brkysnturk/turret_fcs/docs/cad/Flywheel_experiment_1.stl

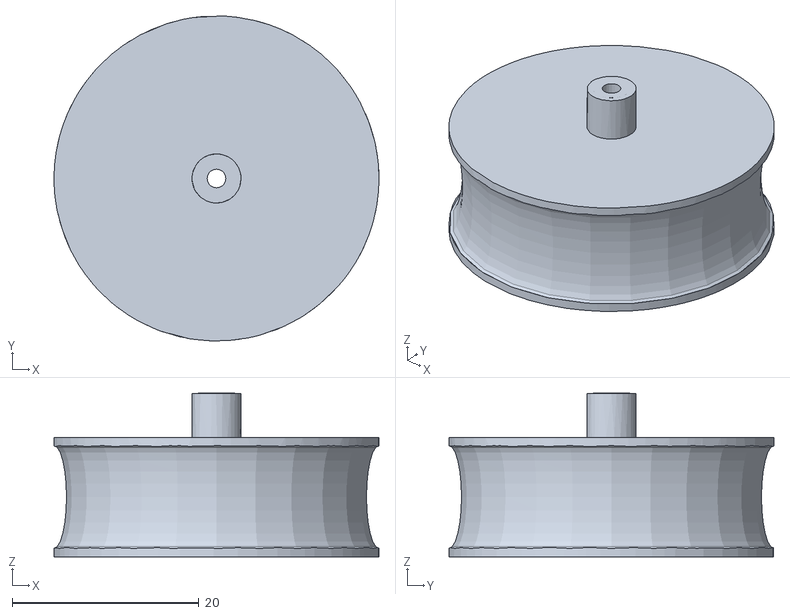
[picture p17: CAD file, 2026-10-21]
docs/cad/Flywheel_experiment_1.stl
34.8 x 34.8 x 17.5
