brkysnturk/turret_fcs/webots/worlds/tf_luna/TF-Luna 3D structure.obj

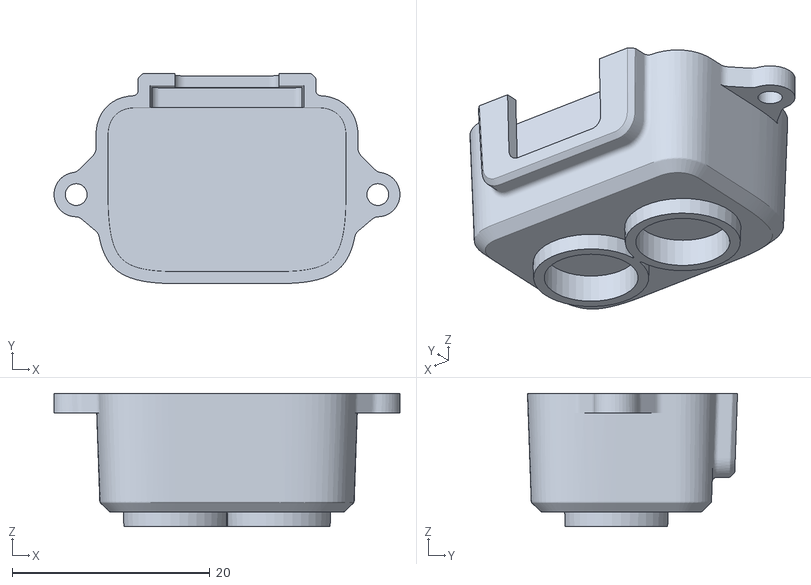
[picture p19: CAD file, 2026-10-05]
webots/worlds/tf_luna/TF-Luna 3D structure.obj
35.0 x 21.2 x 13.5
