brkysnturk/turret_fcs/(commit log)

2026-10-05 feat: initial commit - Turret FCS autonomous targeting, Webots simulation, and STM32 firmware
    [TF-Luna 3D structure.obj, red ballon.obj]
2026-10-05 feat(hsv): modernize and modularize C++ HSV pipeline with CLAHE, fast morphology, MJPG camera thread and analysis charts
2026-10-08 fix(control): align default controller gains and calibrate smooth Lissajous patrol baseline
    [fcs_manager.py, main.py, pid_controller.py]
2026-10-08 docs: update README with root analysis, telemetry logging and ESC shutdown
2026-10-08 feat(stm32): add STM32 Nucleo firmware project and clean standalone test folders
2026-10-11 feat(hardware): add 3D CAD mechanical assembly renders and update documentation
2026-10-13 feat(fcs): integrate P/RL hybrid controller, ego-motion Kalman filter, C270 optics, and 300 DPI analysis figures
2026-10-13 feat(release): v1.0.0 - 3-stage circular patrol, MIL-STD tactical HUD event log, and unified sensor fusion architecture
    - Core FCS: Integrated 3-stage calm circular/elliptical patrol generator (1.5s lost-target hold -> 20 deg/s smooth center return -> dual-axis sinusoidal conic scan)
    - Tactical HUD: Added MIL-STD tactical console event log with SSOT architecture, combat decluttering, strict color discipline (Green/Amber/Red), and graded hit probability
    - Embedded & Comms: Full-Duplex binary 115200 Baud UART (7B TX / 6B RX with XOR checksum), automatic ST-Link VID 0483 plug-and-play detection, and hardware-level TF-Luna LiDAR firmware interrupt (luna_read.c)
    - Simulation & Testing: Fully sync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
2026-10-14 feat(v1.1): 2-DOF velocity feedforward, pipeline-aligned PPO RL, and multi-tier fail-safe architecture
    [fcs_comm.py, fcs_manager.py, kalman_filter.py, main.c, main.py, rl_controller.py, target_selector.py]
2026-10-14 feat(v1.1): add 1st-order actuator observer for ego-motion compensation and sync UART docstring
2026-10-19 fix(fcs): make lock exit threshold dynamic with 0.60 deg hysteresis margin
    [lock_manager.py]
2026-10-19 refactor(config): standardize calibration comments to Ev: x | Okul: y format and remove legacy fallbacks
2026-10-20 feat(patrol): overhaul airspace patrol with odometry return-to-center, wide 45x16 angles, and unified tactical HUD
2026-10-20 feat(calibration): add interactive camera calibration tool and align optics to official 55 deg dFOV standard
2026-10-20 feat(control): add step accumulator for patrol RTB and dynamic velocity deadband
    - Add step accumulator in patrol_generator to overcome MG996R deadband during RTB
    - Implement dynamic Kalman velocity deadband scaling with ego-speed and distance
    - Introduce tracking hysteresis (conf=0.16) in target_selector to handle motion blur
    - Add real-time target_conf to telemetry CSV and HUD target label
    - Synchronize Webots HUD and update AGENTS.md and README.md
2026-10-21 feat(architecture): establish SSOT configuration, package structure, and repository hygiene
    [Flywheel_experiment_1.stl]
2026-10-21 feat(telemetry): implement telemetry v2 with hardware odometry sync and JSON metadata sidecar
2026-10-21 feat(control): calibrate adaptive CWNA Kalman filter, Type-1 P controller, and physical/eval lock management
2026-10-21 feat(rl): redesign LQR reward, optimize hyperparameters with Optuna, and retrain 250k PPO agent
    [rl_controller.py]
2026-10-21 fix(stm32): decouple telemetry from LiDAR, make watchdog unconditional, add atomic command read and step limits
    [fcs_comm.c, luna_read.c, main.c, servo_driver.c]
2026-10-21 test(ci): implement comprehensive 19-case pytest suite and robust GitHub Actions CI workflow
2026-10-21 feat(analysis): academic control analysis tools, publication figures, and benchmark evidence
    [v1.2_baseline.csv, v1.3_benchmark.csv]
2026-10-24 feat(kalman): replace the adaptive filter with a CV model
    [kalman_filter.py]
2026-10-24 feat(fcs): harden LiDAR gating, UART parsing, and the Webots twin
2026-10-24 refactor(control): make P and RL the single production controllers
    Promote the former P MAX to turret_fcs/p_controller.py (PController) and the former RL MAX to turret_fcs/rl_controller.py (RLController). Delete the legacy controllers, both factory selectors, the p_controller_impl / rl_controller_impl config fields, the TURRET_P_CONTROLLER / TURRET_RL_CONTROLLER switches, the kp_pan_max / kp_tilt_max aliases, and the v1.3 turret_ppo_final model. Rollback to v1.3 now means checking out the v1.3 tag.
    Remove never-read control config (velocity_ff_*, ff_min_speed_*, ff_full_speed_deg_s, ff_slew_rate_deg_s, ff_error_ramp_deg, ff_stop_*, p_pan_ema_alpha, p_pan_slew_deg, rl_pan_ema_alpha, rl_pan_s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
2026-10-24 fix(setup): make setup_env.bat run on a clean Windows clone
    The batch file failed with '... was unexpected at this time' because the venv/python checks were embedded in chained && blocks and nested if/else inside a parenthesis group. Rewrite it with explicit labels, quoted interpreter paths, and a :try_py helper so py -3.12/3.11/3.10 detection, venv rebuild, CPU-only torch install, editable package install, and import verification all run to completion.
    Verified on a fresh clone: first run from scratch and a second run with an existing venv both exit 0, and the installed environment passes 38/38 tests.
2026-10-24 feat(control): stabilize RL with soft deadband taper, tilt inertia limit, and clean HUD labels
    - Add soft deadband taper (0.85 pan, 0.95 tilt) with cubic smoothstep transition to suppress continuous policy zero-bias jitter.
    - Scale tilt max step to 0.75 deg (22.5 deg/s) and widen tilt taper to 2.50 deg to eliminate 4.5 deg transport-lag overshoot.
    - Wire command acceleration limits (120 pan / 80 tilt deg/s^2) in FCSManager.
    - Update HUD mode banner text to 'P Controller' and 'RL Controller'.
    - Validated on live physical turret (telemetry 145910): lock rate jumped from 1.5% to 47.4%, tilt command reversals dropped from 4.7% to 0.5% (close-range tilt command: 0.002 deg/frame).
    - Unit test suit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
    [config.py, fcs_manager.py, rl_controller.py, turret_hud.py]
2026-10-24 test(config): lock the SSOT contract for every config field
    Add regression tests that pin PController and RLController defaults to CONFIG (far gain, acceleration limits, deadband, taper, velocity/distance scales), assert TurretEnv shares the same RL scale, check the Webots EVAL duration comes from config, and fail if any CONFIG field stops being read by production code.
    Also source the flywheel test controller's target speed and fire cooldown from CONFIG instead of duplicated literals. Suite is 44 tests.
2026-10-24 fix(firmware): close six safety and robustness gaps in the STM32 stack
    Add an independent watchdog (IWDG, ~800 ms) configured at register level so no CubeIDE build file has to change; a hang or Error_Handler now reboots the MCU and pulls the launcher pins low again instead of leaving the flywheel energised forever. DBGMCU freezes the IWDG on breakpoints in DEBUG builds.
    Make E-stop rate limited: the direct Servo_SetPan(90) write bypassed MAX_STEP and produced a torque spike of up to 45 degrees. Servo_HomeStep() now walks to centre at 45 deg/s. A second 2000 ms timeout parks the servos when the PC stays away, so the two MG996R units stop drawing stall current indefinitely.
    Validate the prot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
    [fcs_comm.c, main.c, servo_driver.c]
2026-10-24 refactor(firmware): drive the independent watchdog through the STM32Cube HAL driver
    Replace the register-level IWDG setup with the vendor driver: copy stm32f4xx_hal_iwdg.c/.h from the STM32Cube FW_F4 V1.28.3 package (same HAL 1.8.5 as the project), enable HAL_IWDG_MODULE_ENABLED, and add MX_IWDG_Init() using IWDG_PRESCALER_64 with reload 400 for an 800 ms window. The main loop now calls HAL_IWDG_Refresh(&hiwdg), and the DEBUG freeze uses __HAL_DBGMCU_FREEZE_IWDG() instead of a raw DBGMCU write.
    Register IWDG in the .ioc as well so a CubeMX regeneration keeps the module enabled, its parameters, and the HAL source files. Behaviour is unchanged: the same 800 ms timeout, LSI tolerance included.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
    [main.c]
2026-10-24 feat(repo): clean repository bloat, migrate weights to release assets, and sync docs
    [v1.2_baseline.csv, v1.3_benchmark.csv]
2026-10-24 fix(control): stabilize tracking, restore 150px Kalman gate, and dynamic limits
    - Restore physical 150 px residual jump gate in KalmanFilter (NIS gate rejected normal 30-70 px slew innovations in telemetry causing false resets)
    - Add dynamic slew log replay regression test in test_kalman.py
    - Remove gain scheduling from PController for linear Type-1 behavior
    - Increase command acceleration limits to 400.0/267.0 deg/s^2 for agile tracking
    - Add on_target_lost() command reset to prevent wrong-direction steering on reacquisition
    - Align ego motion observer discretization with backward Euler plant model
    - Clean up dead flags in RLController and update rl_diagnose ceiling labels
    - Synchronize Pha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
    [config.py, fcs_manager.py, kalman_filter.py, rl_controller.py]
2026-10-24 fix(integration): align webots keymap signature, HUD active firing state, and entrypoint contracts
    [fcs_manager.py, main.py]
2026-10-24 refactor: resolve technical debts across RL diagnose, deadband semantics, and documentation
    [main.py, rl_controller.py, weights.py]
2026-10-24 fix(estop): centralize patrol disable and fcs reset in keymap, add AST contract verification
    [keymap.py]
2026-10-24 docs(rl): synchronize RL zero-velocity observation across docs, controller, and diagnose
2026-10-24 docs: rewrite README with current architecture and module guide
2026-10-24 docs: use current architecture diagram and remove duplicated data flow
2026-10-24 chore: exclude generated STM32 startup and linker files from language stats
2026-10-24 refactor(protocol): add PC/STM32 binary protocol single-source modules
    Frame lengths, header bytes, angle scale and state codes were duplicated in
    fcs_comm.py and the fcs_comm/luna_read headers, so a one-sided change could
    shift fields while still passing the checksum.
    - add turret_fcs/protocol.py and Core/Inc/protocol.h as the shared contract
    - drive fcs_comm.py and the firmware parsers from PROTO_* constants
    - cover the telemetry frame with struct.pack using protocol constants
2026-10-24 feat(firmware): latch blue-button E-stop and add module documentation headers
    - B1 (PC13/EXTI13) becomes a latched software E-stop with internal pull-up
    and 250 ms debounce: the first press cuts the launcher, parks the servos and
    ignores PC commands; the second press releases the latch.
    - enable EXTI15_10 and USART2 NVIC lines in main.c and turret_main.ioc so a
    CubeMX regeneration no longer drops the PC command interrupt.
    - add a safe default branch to Launcher_Update for invalid states.
    - add module headers to servo_driver, luna_read, flywheel_solenoid and the
    related headers.
    - document the Debug/Release build configurations, their sizes and the
    latched E-stop behaviour in docs/f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
    [main.c, servo_driver.c]
2026-10-24 chore(analysis): add README diagram generator and ignore Release builds
    - add analysis/generate_readme_diagrams.py so the README architecture figures
    can be regenerated from the current module layout
    - ignore stm32/**/Release/ alongside the existing Debug/ build output
2026-10-24 docs(memory): record the HAL watchdog build sizes and runtime RL velocity
    - update the firmware verification figures to the Debug and Release builds
    - correct FAZ 14 point 8: the RL runtime Kalman velocity observation is zeroed
    to `0.0` (not enabled), matching fcs_manager and rl_controller
2026-10-24 fix(analysis): label fig7/fig8 as simulations and regenerate figures
    Both figures are produced by the closed-loop simulator in
    analysis/plot_tuned_system.py (seeded with np.random.seed), yet the file names
    claimed real-hardware measurements. Rename them to fig7_sim_still_lock and
    fig8_sim_moving_tracking and note the simulation origin in the README table.
    Regenerate every figure with the current script so the tracked images match
    the code that produces them.
2026-10-24 fix(rl): widen soft deadband taper
    Increase the pan and tilt taper widths for smoother RL output near the deadband, and remove unused LOS filter parameters from control configuration.
    [config.py]
